dominicbeesley/beeb-kb-ps2/README.md

# beeb-kb-ps2
A BBC Micro Keyboard to PS/2 converter

<p align="center">
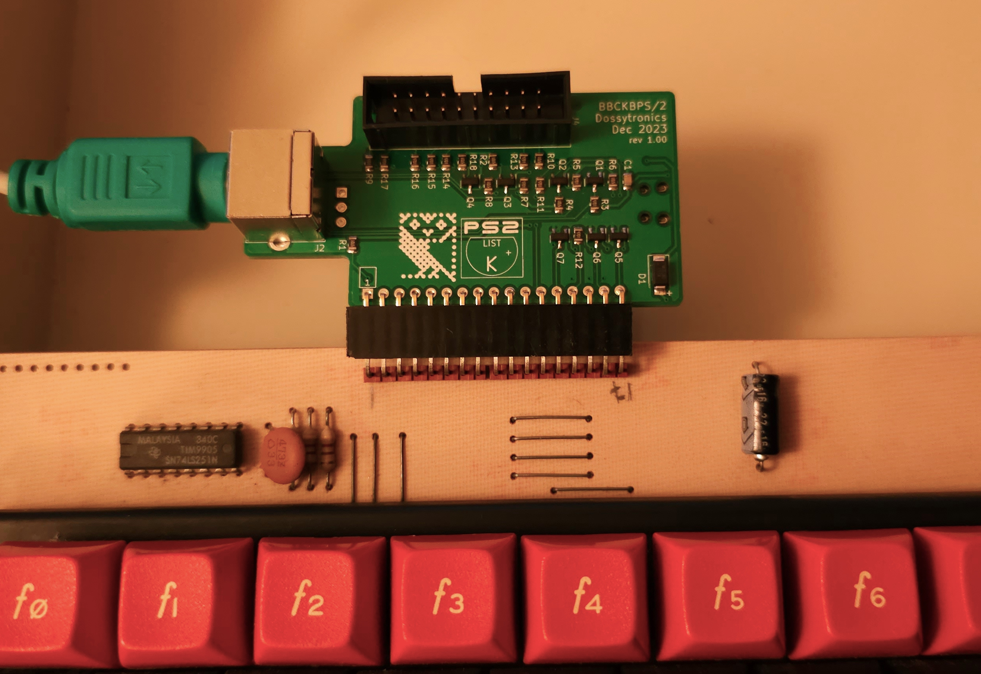
[picture p1: assets/board-on-keyboard.jpg]

</p>
