dominicbeesley/beeb-kb-ps2/pcb/Next2BeebKB.pdf

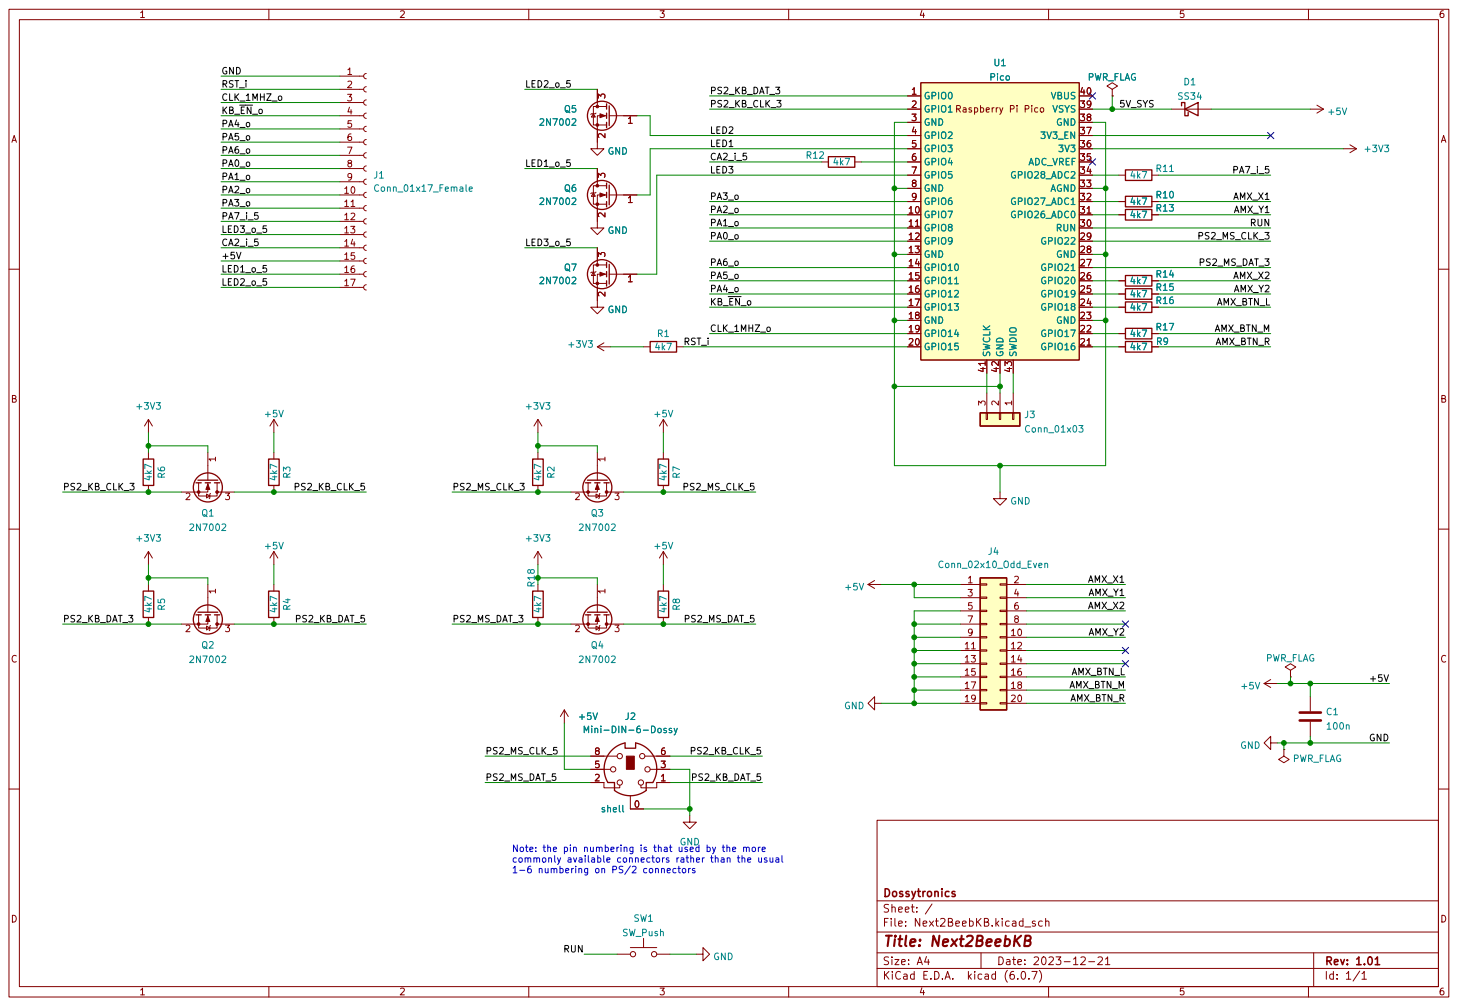
[picture p2: page 1]

PS2_KB_CLK_3
1-6 numbering on PS/2 connectors +5V GND

commonly available connectors rather than the usual
