dominicbeesley/beeb-kb-ps2/pcb/Next2BeebKB.kicad_pcb

## KiCad design pcb/Next2BeebKB.kicad_pcb (2025-07-10)

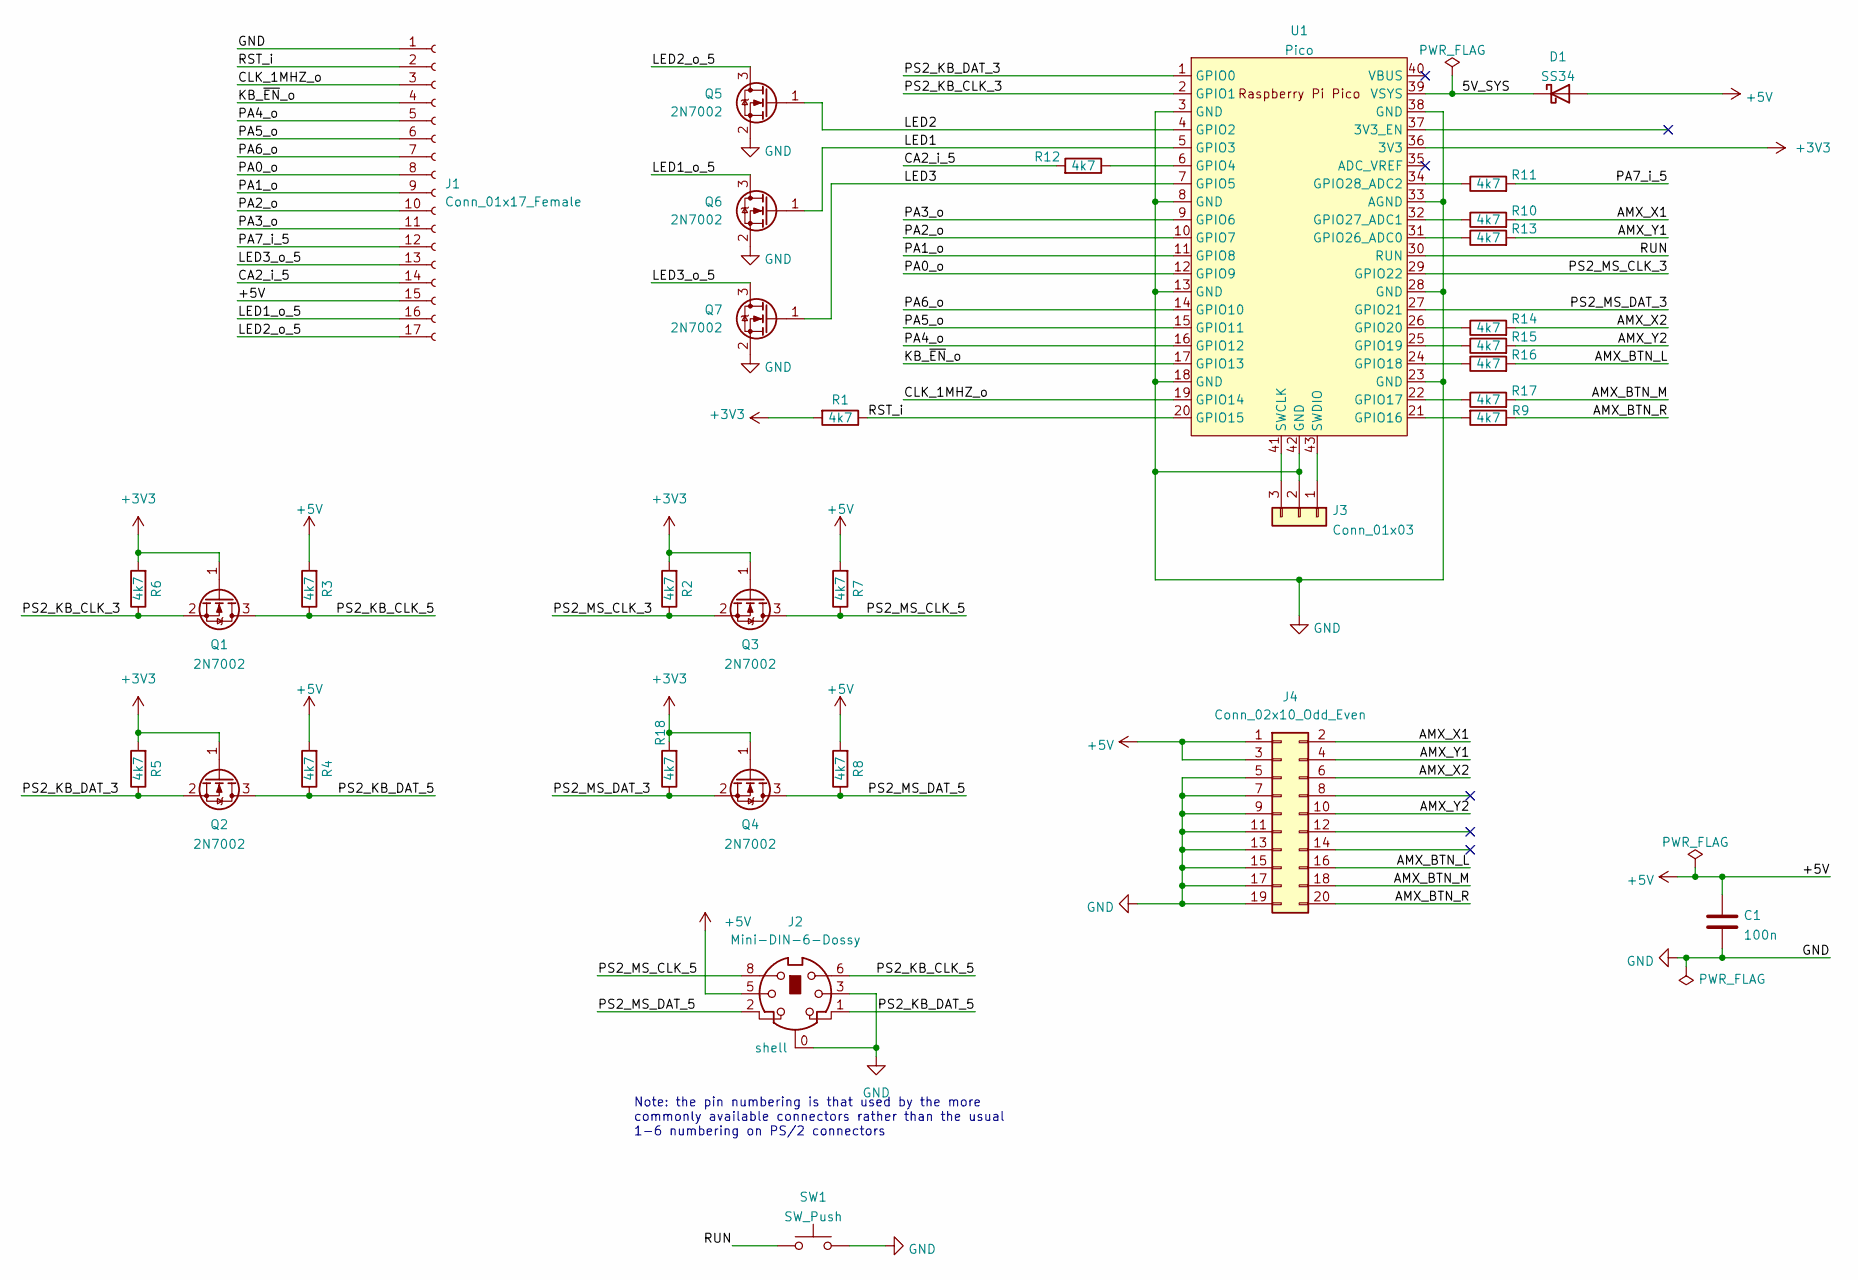
[picture p3: schematic Next2BeebKB.kicad_sch]

Parts:
C1: 100n; C_0805_2012Metric; LCSC C49678
D1: SS34; D_SMA; LCSC C8678
J1: Conn_01x17_Female; PinSocket_1x17_P2.54mm_Vertical
J2: Mini-DIN-6-Dossy; PS2 mini din 6
J3: Conn_01x03; PinHeader_1x03_P2.54mm_Vertical
J4: Conn_02x10_Odd_Even; IDC-Header_2x10_P2.54mm_Vertical
Q1, Q2, Q5, Q6, Q7: 2N7002; SOT-23; LCSC C8545
Q3, Q4: 2N7002; SOT-23
R1, R2, R3, R4, R5, R6, R7, R8, R9, R11, R12, R13, R14, R15, R16, R17, R18: 4k7; R_0805_2012Metric; LCSC C17673
R10: 4k7; R_0805_2012Metric
SW1: SW_Push; SW_SPST_GEN
U1: Pico; RPi_Pico_SMD

Connections:
+3V3: Q1.1 (G), Q2.1 (G), Q3.1 (G), Q4.1 (G), R1.2, R2.2, R5.2, R6.2, R18.2, U1.36 (3V3)
+5V: C1.1, D1.2 (A), J1.15, J2.5, J4.1, J4.3, R3.2, R4.2, R7.2, R8.2
/5V_SYS: D1.1 (K), U1.39 (VSYS)
/AMX_BTN_L: J4.16, R16.2
/AMX_BTN_M: J4.18, R17.2
/AMX_BTN_R: J4.20, R9.1
/AMX_X1: J4.2, R10.2
/AMX_X2: J4.6, R14.2
/AMX_Y1: J4.4, R13.2
/AMX_Y2: J4.10, R15.2
/CA2_i_5: J1.14, R12.2
/CLK_1MHZ_o: J1.3, U1.19 (GPIO14)
/KB_~EN_o: J1.4, U1.17 (GPIO13)
/LED1: Q6.1 (G), U1.5 (GPIO3)
/LED1_o_5: J1.16, Q6.3 (D)
/LED2: Q5.1 (G), U1.4 (GPIO2)
/LED2_o_5: J1.17, Q5.3 (D)
/LED3: Q7.1 (G), U1.7 (GPIO5)
/LED3_o_5: J1.13, Q7.3 (D)
/PA0_o: J1.8, U1.12 (GPIO9)
/PA1_o: J1.9, U1.11 (GPIO8)
/PA2_o: J1.10, U1.10 (GPIO7)
/PA3_o: J1.11, U1.9 (GPIO6)
/PA4_o: J1.5, U1.16 (GPIO12)
/PA5_o: J1.6, U1.15 (GPIO11)
/PA6_o: J1.7, U1.14 (GPIO10)
/PA7_i_5: J1.12, R11.2
/PS2_KB_CLK_3: Q1.2 (S), R6.1, U1.2 (GPIO1)
/PS2_KB_CLK_5: J2.6, Q1.3 (D), R3.1
/PS2_KB_DAT_3: Q2.2 (S), R5.1, U1.1 (GPIO0)
/PS2_KB_DAT_5: J2.1, Q2.3 (D), R4.1
/PS2_MS_CLK_3: Q3.2 (S), R2.1, U1.29 (GPIO22)
/PS2_MS_CLK_5: J2.8, Q3.3 (D), R7.1
/PS2_MS_DAT_3: Q4.2 (S), R18.1, U1.27 (GPIO21)
/PS2_MS_DAT_5: J2.2, Q4.3 (D), R8.1
/RST_i: J1.2, R1.1, U1.20 (GPIO15)
/RUN: SW1.1, U1.30 (RUN)
GND: C1.2, J1.1, J2.0 (shell), J2.3, J3.2, J4.5, J4.7, J4.9, J4.11, J4.13, J4.15, J4.17, J4.19, Q5.2 (S), Q6.2 (S), Q7.2 (S), SW1.2, U1.3 (GND), U1.8 (GND), U1.13 (GND), U1.18 (GND), U1.23 (GND), U1.28 (GND), U1.33 (AGND), U1.38 (GND), U1.42 (GND)
unnamed: J3.1, U1.43 (SWDIO)
unnamed: J3.3, U1.41 (SWCLK)
unnamed: R9.2, U1.21 (GPIO16)
unnamed: R10.1, U1.32 (GPIO27_ADC1)
unnamed: R11.1, U1.34 (GPIO28_ADC2)
unnamed: R12.1, U1.6 (GPIO4)
unnamed: R13.1, U1.31 (GPIO26_ADC0)
unnamed: R14.1, U1.26 (GPIO20)
unnamed: R15.1, U1.25 (GPIO19)
unnamed: R16.1, U1.24 (GPIO18)
unnamed: R17.1, U1.22 (GPIO17)

Notes on the sheet:
Note: the pin numbering is that used by the more commonly available connectors rather than the usual 1-6 numbering on PS/2 connectors

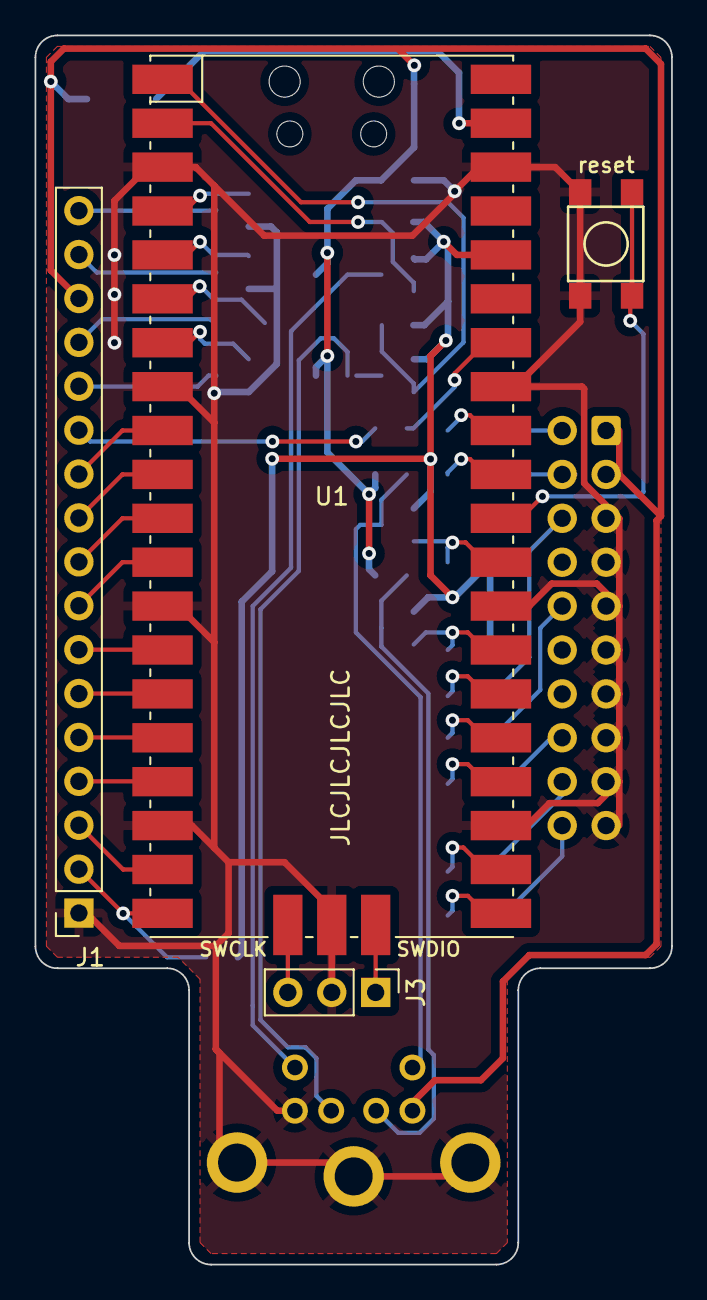
[picture p4: board Next2BeebKB.kicad_pcb from above]

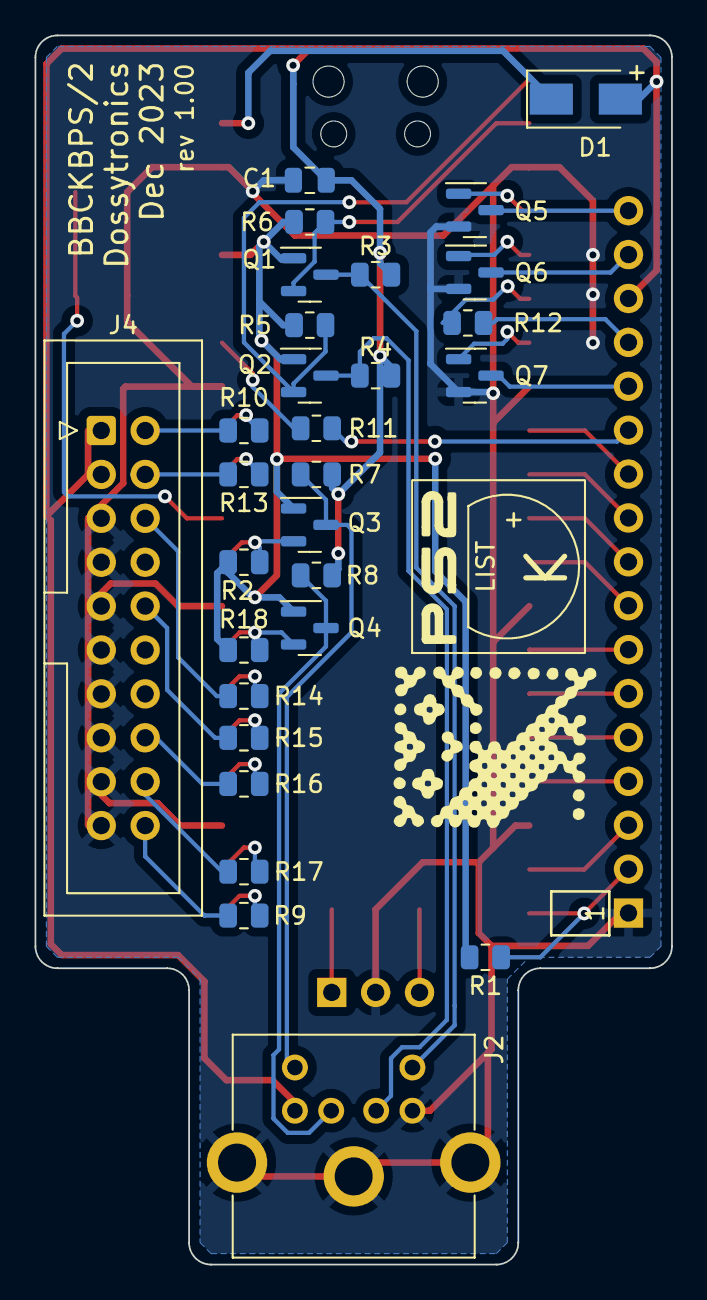
[picture p5: board Next2BeebKB.kicad_pcb from below]

Board: 2 copper layers, 36.8 x 71.1 mm, 33 parts (29 on the bottom side), 49 nets.
