dominicbeesley/beeb-kb-ps2/firmware/pins.h

#ifndef __BEEBKEYNEXTPINS_H__
#define __BEEBKEYNEXTPINS_H__

//PS/2 connector - keyboard
#define GPIO_PS2KB_DAT_PIN  0
#define GPIO_PS2KB_CLK_PIN  1
//PS/2 connector - mouse
#define GPIO_PS2MS_DAT_PIN  21
#define GPIO_PS2MS_CLK_PIN  22

//AMX connector
#define GPIO_AMX_BTN_L      18
#define GPIO_AMX_BTN_M      17
#define GPIO_AMX_BTN_R      16
#define GPIO_AMX_X1         27
#define GPIO_AMX_X2         20
#define GPIO_AMX_Y1         26
#define GPIO_AMX_Y2         19


#define GPIO_CA2_IN_PIN     4
#define GPIO_KB_EN_PIN      13
#define GPIO_1MHZ_PIN       14
#define GPIO_PA7_IN_PIN     28

#define GPIO_PA0_OUT_PIN    9
#define GPIO_PA1_OUT_PIN    8
#define GPIO_PA2_OUT_PIN    7
#define GPIO_PA3_OUT_PIN    6
#define GPIO_PA4_OUT_PIN    12
#define GPIO_PA5_OUT_PIN    11
#define GPIO_PA6_OUT_PIN    10

#define GPIO_LED1_PIN       3
#define GPIO_LED2_PIN       2
#define GPIO_LED3_PIN       5

#define GPIO_RST_IN         15

#endif
