dominicbeesley/beeb-kb-ps2/(commit log)

2024-01-08 repin for updated board
2024-01-10 FIX: host to device communication got stuck
    [beebKeyNext.c, ps2comm.c, ps2comm.h]
2024-01-10 correct polarity and ordering of LEDs
    [beebKeyNext.c]
2024-01-12 mouse wiring
2024-01-12 read mouse with interrupts test
2024-01-13 mouse 1st cut working in 4 byte stream mode
2024-01-25 Fixes for protocol not working when inhibited by host
    Still not working with LEDs on PS2/USB
    [beeb-keyboard.c, beebKeyNext.c, ps2comm.c]
2025-07-10 Add pcb
    [Next2BeebKB.kicad_pcb, Next2BeebKB.kicad_sch]
